yigithansari/ARGOS/images/hardware/phase-00/19-07-2026-power_module_back.jpeg

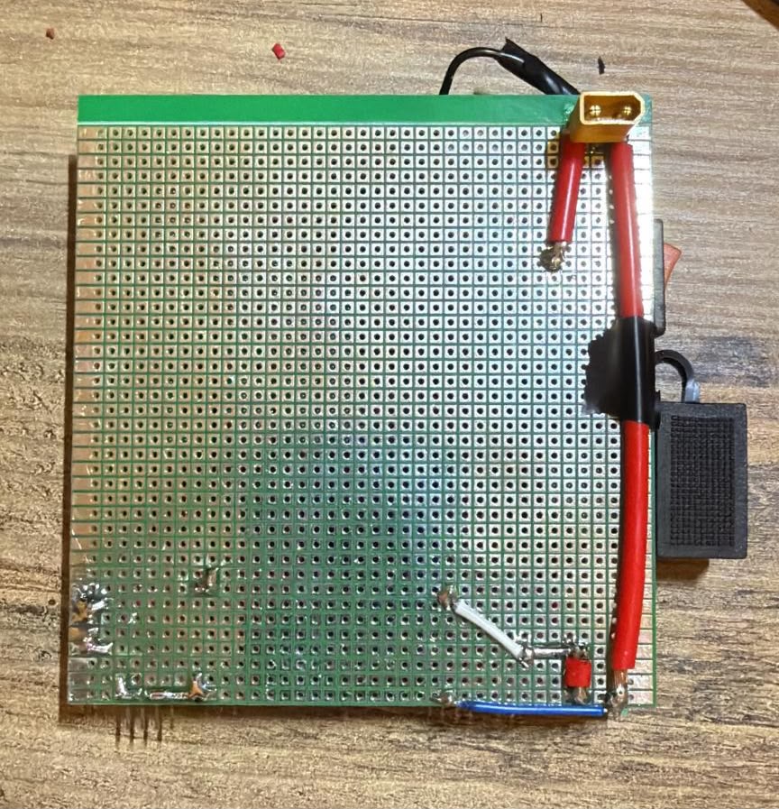
images/hardware/phase-00/19-07-2026-power_module_back.jpeg
