yigithansari/ARGOS/README.md

# ARGOS

## Autonomous Robotic Guard & Observation System

A long-term autonomous robotics platform developed to master embedded systems, robotics, autonomous navigation and system engineering.

## Current Status

**Phase 00 is certified, Phase 01 - Mobile Platform is complete, and Phase 02 - Motion Control is active.**

The Phase 00 bench platform passed its final integrated system test on 2026-09-29. It includes Power Module V1, STM32 firmware, independent bidirectional motor control, encoder telemetry, MPU6050 and dual VL53L0X sensing, USB/UART communication, an ESP32-C3 wireless bridge, an SSD1306 OLED status display, and a Python control panel. The archived [system-test report](tests/phase-00/2026-09-29-system-test-report.txt) records the certification evidence.

The first mobile platform is assembled. Chassis V1 and Wheel V5 manufacturing files are archived under [`hardware/mechanical/`](hardware/mechanical/), and current photographs are stored under [`images/hardware/phase-01/`](images/hardware/phase-01/). The robot can move and stop safely under computer control through a Windows hotspot and the ESP32-C3 bridge.

Phase 02 currently focuses on per-wheel feed-forward plus PI speed control. Wheel geometry, encoder scaling, and low-band PWM/RPM characterization are complete. Single raised-wheel forward runs at 25, 35, and 45 RPM met the initial mean tracking target; repeated runs, reverse operation, disconnect-stop latency, and floor tuning remain open. Battery charge level is not currently measured or displayed.

## Overview

ARGOS is a long-term engineering project focused on designing and developing a modular autonomous indoor security robot.

Unlike hobby robots, ARGOS is not intended to be a simple proof-of-concept or an Arduino-based demonstration platform. It is being developed using a professional product development methodology where every subsystem is validated before custom hardware is designed.

The project combines embedded systems, electronics, robotics, software engineering and autonomous decision-making into a single evolving platform.

The ultimate objective is to create a reliable robotic system while documenting every engineering decision throughout the development process.

## Why ARGOS?

The primary goal of ARGOS is education through engineering.

Instead of building isolated projects, ARGOS acts as a continuously evolving robotics platform where every new subsystem extends the capabilities of the previous generation.

By the end of the project, ARGOS will demonstrate practical experience in:

- Embedded Systems
- STM32 Development
- PCB Design
- Motor Control
- Robotics
- Sensor Fusion
- Autonomous Navigation
- Battery Management
- Communication Systems
- Software Architecture
- System Engineering
- Product Development

## Project Philosophy

ARGOS follows one fundamental engineering principle:

> Validate first. Design later.

Every subsystem is first implemented using development boards and modular hardware.

Only after validating the electrical, mechanical and software architecture will dedicated PCBs be designed.

This approach minimizes redesign effort while closely following industrial product development workflows.

## Long-Term Vision

The final version of ARGOS is planned to become a fully autonomous indoor security robot capable of:

- Autonomous indoor navigation
- Patrol missions
- Obstacle avoidance
- Environment perception
- Remote mission execution
- Wireless telemetry
- Home server integration
- Automatic charging (future)
- Camera-based monitoring (future)
- Event logging
- Future self-balancing platform

## System Architecture

                   Home Server
             (MQTT - Dashboard - Logs)
                         |
                   Wi-Fi (Future)
                         |
                Raspberry Pi / SBC
                         |
                    UART / SPI
                         |
                STM32 Main Controller
                         |
        +----------------+----------------+
        |                |                |
   Motor Control    Sensor System    Power System
        |                |                |
  Encoder Motors     IMU - ToF      Battery - BMS

## Development Roadmap

### Phase 00 - Bench Validation

**Status:** Complete - Certified 2026-09-29.

The objective of this phase is validating all core hardware modules independently.

Topics:

- STM32 development environment
- PWM generation
- Encoder reading
- Motor driver evaluation
- Serial debugging

### Phase 01 - Mobile Platform

Build the first functional mobile robot.

**Status:** Complete - assembled mobile platform and safe basic motion.

Main goals:

- Differential drive
- Encoder feedback
- PID speed control
- Reliable movement

### Phase 02 - Motion Control

Develop repeatable closed-loop wheel-speed and differential-drive control.

**Status:** Active - PI tuning.

Topics:

- Independent wheel-speed PI control
- Straight-line repeatability
- Wheel odometry
- Distance and angle commands

### Phase 03 - Localization and Basic Autonomy

Introduce autonomous behavior.

Features:

- Obstacle avoidance
- Basic navigation
- Safety state machine

### Phase 04 - Custom Electronics

Replace development boards with custom-designed hardware.

Goals:

- STM32 custom PCB
- Motor driver PCB
- Power distribution
- Professional wiring architecture

### Phase 05 - Home Server Integration

Enable wireless communication.

Features:

- MQTT
- Telemetry
- Dashboard
- Remote mission commands

### Phase 06 - Security Robot

Transform ARGOS into an autonomous indoor security platform.

Possible capabilities:

- Patrol mode
- Monitoring
- Event detection
- Logging
- Camera integration

### Phase 07 - Next Generation Platform

Potential future upgrades:

- Self-balancing platform
- Improved perception
- Advanced autonomy
- Additional robotic modules

## Technologies

### Embedded

- STM32F446RE
- STM32 HAL
- Embedded C

### Electronics

- Altium Designer
- PCB Design
- Power Electronics

### Robotics

- Differential Drive
- PID Control
- Odometry
- Sensor Fusion

### Software

- Python
- Git
- GitHub

### Future Technologies

- Raspberry Pi
- MQTT
- Docker
- Home Assistant
- Proxmox
- OpenCV

## Repository Structure

- `docs/` - Project vision, requirements, architecture, and implementation documentation.
- `phases/` - Authoritative phase register and detailed active/completed phase records.
- `hardware/` - Mechanical and future electronic design files, including Chassis V1.
- `firmware/` - STM32 and ESP32-C3 firmware projects.
- `software/` - Python control, telemetry, and validation tools.
- `tests/` - Certification evidence, validation reports, and future phase test records.
- `journal/` - Chronological engineering decisions and milestone records.
- `images/` - Diagrams and phase-specific hardware/software evidence.
- `resources/`, `tools/`, `videos/`, `archive/` - Supporting project material.

See the [`phases/` register](phases/README.md) for the current engineering state.

## Documentation

Every engineering decision will be documented.

The repository will include:

- Project Architecture
- Hardware Architecture
- Software Architecture
- Mechanical Design
- Test Reports
- Development Logs
- Lessons Learned
- Bill of Materials (BOM)
- Design Reviews

## Engineering Principles

ARGOS is developed according to the following principles:

- Modularity
- Reliability
- Maintainability
- Scalability
- Documentation First
- Incremental Development
- Version Control
- Engineering Validation Before Hardware Design

## License

This repository is currently intended for educational and portfolio purposes.
