yigithansari/ARGOS/phases/README.md

# ARGOS Development Phases

This directory is the authoritative phase register for ARGOS.

## Current Phase

**Phase 02 - Motion Control is active.** The mobile platform is assembled and safe basic motion is available. Current work is independent wheel-speed PI tuning and repeatability validation.

## Phase Register

| Phase | Name | Status | Primary Record |
| --- | --- | --- | --- |
| Phase 00 | Bench Validation | Complete - Certified 2026-09-29 | [`phase-00-bench-validation.md`](phase-00-bench-validation.md) |
| Phase 01 | Mobile Platform | Complete - 2026-10-31 | [`phase-01-mobile-platform.md`](phase-01-mobile-platform.md) |
| Phase 02 | Motion Control | Active - PI tuning | [`phase-02-motion-control.md`](phase-02-motion-control.md) |
| Phase 03 | Localization and Basic Autonomy | Planned | To be created when Phase 02 exit criteria are met. |
| Phase 04 | Custom Electronics | Planned | To be created when platform requirements stabilize. |
| Phase 05 | Home Server Integration | Planned | Future phase. |
| Phase 06 | Security Robot | Planned | Future phase. |
| Phase 07 | Next Generation Platform | Concept | Long-term expansion. |

## Phase Rules

- Each active phase has one detailed phase document.
- Completed phases retain their evidence, limitations, and exit decision.
- Work carried forward is tracked in the active phase without reopening a certified phase.
- New phase documents are created only when the project formally enters that phase.
