yigithansari/ARGOS/images/hardware/phase-01/README.md

# Phase 01 Mobile Platform Photos

This directory contains the first assembled ARGOS mobile-platform photographs.

## Files

- `2026-10-31_ARGOS_Mobile_Platform_Top_View.jpeg` - Top view of the completed chassis, electronics, power module, motor drivers, sensors, and wiring.
- `2026-10-31_ARGOS_Mobile_Platform_Three_Quarter_View.jpeg` - Three-quarter view showing the assembled chassis and wheel installation.

These photographs document the Phase 01 mobile-platform integration baseline before Phase 02 PI tuning and odometry work.
