yigithansari/ARGOS/images/software/phase-00/README.md

# Phase 00 Software Evidence

This directory contains screenshots of the ARGOS control and telemetry interface used during final Phase 00 bench validation.

## Files

- `2026-09-29_ARGOS_Control_Panel_Overview.png` - Full control-panel overview with active Wi-Fi and STM32 connection.
- `2026-09-29_ARGOS_Control_Panel_Telemetry.png` - IMU, ToF, and serial telemetry view during integrated operation.

The machine-generated validation record is stored at `tests/phase-00/2026-09-29-system-test-report.txt`.
