yigithansari/ARGOS/tests/reports/2026-09-17_Phase00_Exit_Report.md

# Phase 00 Exit Report

**Project:** ARGOS - Autonomous Robotic Guard & Observation System
**Phase:** Phase 00 - Bench Validation
**Report Date:** 2026-09-17
**Decision:** Phase 00 Complete - Approved to Proceed to Phase 01
**Certification Date:** 2026-09-29
**Certification Status:** Passed

## 1. Purpose

This report records the formal completion of ARGOS Phase 00. The phase established and validated the electrical, embedded-software, sensing, motor-control, communication, and operator-interface foundation required for the first mobile platform.

Phase completion does not imply that every subsystem has reached final product maturity. It confirms that the bench platform is sufficiently understood, functional, documented, and controlled to begin Phase 01 integration.

## 2. Exit Summary

Phase 00 exit is approved.

The STM32 development workflow, power distribution, motor-driver operation, encoder acquisition, IMU, dual ToF sensing, USB/UART control, ESP32-C3 wireless bridge, OLED status display, and Python control panel have been brought up on the bench.

The remaining calibration and instrumentation-dependent measurements are documented and accepted as carry-over work. None currently prevents controlled mechanical integration.

The exit decision was confirmed by the final integrated system test on 2026-09-29. The generated report records PASS results for UART, I2C discovery, IMU, both ToF sensors, motor safety, encoder response, and bidirectional motor ramps.

## 3. Validated Capabilities

| Area | Result | Evidence / Notes |
| --- | --- | --- |
| STM32 development environment | Passed | Build, upload, debug, and runtime workflow established for NUCLEO-F446RE. |
| Power Module V1 | Passed with open measurements | Electrical checks passed; approved for controlled bench use. Thermal and oscilloscope measurements remain open. |
| UART and USB control | Passed | Command reception and telemetry verified through the STM32 serial interface. |
| Python control panel | Passed | Manual drive controls, telemetry, connection handling, and test functions implemented. |
| PWM generation | Passed | Independent left and right motor commands are operational. |
| Motor-driver operation | Passed | Motor isolation, direction control, stopping, and ramp operation verified. |
| Encoder acquisition | Passed with calibration pending | Direction and count telemetry verified. CPR and gearbox ratio require calibration for accurate wheel RPM. |
| MPU6050 IMU | Passed | Communication and sensor telemetry verified. |
| Dual VL53L0X ToF sensors | Passed | Address assignment and distance telemetry verified for both sensors. |
| ESP32-C3 wireless bridge | Passed | Wi-Fi SoftAP and TCP-to-UART control path implemented with disconnect stop behavior. |
| SSD1306 OLED status display | Passed | STM32-driven local status display integrated. |
| Safety behavior | Passed | Startup stop state, command timeout, direction-change stop window, and emergency stop path implemented. |

## 3.1 Final Certification Evidence

- `tests/phase-00/2026-09-29-system-test-report.txt`
- `tests/phase-00/README.md`
- `images/software/phase-00/2026-09-29_ARGOS_Control_Panel_Overview.png`
- `images/software/phase-00/2026-09-29_ARGOS_Control_Panel_Telemetry.png`
- `images/hardware/phase-00/ARGOS_Phase00_Bench_Platform_Top_View.jpg`

## 4. Phase Deliverables

- Reusable Power Module V1 bench supply and distribution assembly
- STM32CubeIDE firmware project for NUCLEO-F446RE
- Motor, encoder, IMU, ToF, UART, safety, and OLED firmware functions
- ESP32-C3 Wi-Fi-to-UART bridge firmware
- Python desktop control panel
- System diagrams, implementation notes, journal entries, and validation reports
- Recorded pin mappings, command interface, and current hardware architecture

## 5. Accepted Carry-Over Items

The following work remains open and shall continue during early Phase 01 integration:

| Item | Current State | Phase 01 Action |
| --- | --- | --- |
| Low-PWM motor deadband | Motors require a minimum command to overcome static friction, gearbox friction, and internal losses. | Measure each motor's startup threshold and implement minimum-command compensation or a controlled startup kick if required. |
| Encoder scale calibration | Counts and direction are available; physical conversion is not final. | Measure encoder CPR and gearbox ratio, then calibrate wheel RPM and odometry constants. |
| ToF distance calibration | Functional ranging is verified. | Compare readings against known distances and record correction or tolerance. |
| IMU angle validation | Sensor communication and telemetry are verified. | Validate roll and pitch against known reference angles. |
| Power-module thermal test | Not measured with dedicated thermal equipment. | Perform an extended loaded run and record component temperatures when suitable equipment is available. |
| Rail ripple and motor transient test | Not measured because an oscilloscope was unavailable. | Measure 5V ripple and 12V motor-start transients when an oscilloscope is available. |
| Battery level monitoring | Not implemented; charge level is not visible. | Add and validate a battery-voltage sensing circuit during Phase 01 before relying on software state-of-charge indication. |
| Firmware module split | Current platform behavior is concentrated in `argos_platform.c`. | Separate stable functions into dedicated modules as Phase 01 behavior settles. |

## 6. Known Limitations

- The current platform is a bench prototype and is not a final production electrical design.
- Accurate wheel RPM and odometry are not available until encoder scaling is calibrated.
- Very low PWM commands may not produce motion and shall not be treated as a guaranteed operating region.
- Power Module V1 is approved for controlled development use, not certified as a final power subsystem.
- Thermal and oscilloscope-based power-quality evidence is not yet available.

## 7. Exit Criteria Assessment

| Exit Criterion | Assessment |
| --- | --- |
| Development environment operational | Met |
| Power architecture usable for bench integration | Met with documented measurement carry-over |
| Motor control and safe stop behavior operational | Met |
| Encoder direction and counting available | Met; scale calibration carried forward |
| IMU and ToF interfaces operational | Met |
| Wired and wireless command paths operational | Met |
| Operator telemetry and local status available | Met |
| Known limitations documented | Met |
| Repository contains implementation and validation evidence | Met |

## 8. Engineering Decision

ARGOS Phase 00 - Bench Validation is complete as of 2026-09-17.

The platform is approved to proceed to **Phase 01 - Mobile Platform**, with the carry-over items in this report tracked during early mechanical and motion integration. Any wiring, load profile, motor, encoder, battery, or power-module change shall trigger targeted revalidation of the affected subsystem.
