yigithansari/ARGOS/docs/02_engineering_principles.md

# ARGOS Engineering Principles

**Document ID:** DOC-002
**Document Title:** Engineering Principles
**Version:** 1.0 (Draft)
**Status:** Active
**Project:** ARGOS – Autonomous Robotic Guard & Observation System

---

## 1. Purpose

This document defines the engineering principles that guide every design decision made throughout the ARGOS project.

Unlike technical requirements, engineering principles are not tied to a specific subsystem or development phase. Instead, they establish the philosophy behind the project and provide a consistent framework for evaluating future decisions.

Whenever multiple technical solutions are possible, these principles should be used to determine the most appropriate engineering choice.

---

## 2. Why Engineering Principles?

Large engineering projects often fail not because of poor implementation, but because decisions become inconsistent over time.

As the ARGOS platform evolves, dozens of hardware, software and mechanical decisions will be made.

This document exists to ensure those decisions remain consistent with the original vision of the project.

Engineering principles reduce unnecessary redesign, simplify future maintenance and improve long-term system reliability.

---

## 3. Core Engineering Principles

### EP-001 — Validate Before Designing

Prototype first.

Custom hardware later.

Every subsystem shall first be validated using development boards or modular hardware before designing dedicated PCBs.

No custom PCB should be designed based solely on theoretical assumptions.

---

### EP-002 — Reliability Before Features

A reliable robot with fewer features is always preferred over a feature-rich robot that behaves unpredictably.

New capabilities must never reduce system stability.

---

### EP-003 — Safety Before Performance

System safety shall always have higher priority than speed, autonomy or additional functionality.

The robot shall always be capable of entering a safe state when unexpected conditions occur.

---

### EP-004 — Incremental Development

ARGOS shall evolve through small measurable milestones.

Every completed phase must leave the robot in a fully functional state before additional complexity is introduced.

Large architectural redesigns should be avoided whenever possible.

---

### EP-005 — Modular Design

Every subsystem should be designed as independently as practical.

Examples include:

- Motor control
- Power distribution
- Sensor interfaces
- Communication
- Navigation
- Diagnostics

Subsystems should communicate through clearly defined interfaces.

---

### EP-006 — Documentation First

Every important engineering decision shall be documented.

Documentation should explain:

- Why the decision was made.
- Which alternatives were considered.
- What trade-offs were accepted.

Future engineers should be able to understand the reasoning behind every major design choice.

---

### EP-007 — Testability

Every subsystem shall be testable independently.

Testing should not require the complete robot whenever possible.

Individual hardware modules should support standalone validation.

---

### EP-008 — Simplicity

Whenever two solutions provide similar performance, the simpler solution should be selected.

Complexity should only be introduced when it provides measurable engineering value.

---

### EP-009 — Scalability

Every subsystem should allow future expansion without requiring complete redesign.

The first generation should not limit future generations.

---

### EP-010 — Maintainability

Hardware shall be easy to assemble, disassemble and repair.

Firmware shall remain modular, readable and reusable.

Future maintenance should always be considered during design.

---

### EP-011 — Reusability

Subsystems developed for ARGOS should be reusable in future robotics or embedded projects whenever practical.

Knowledge gained from one subsystem should benefit future developments.

---

### EP-012 — Measurable Engineering

Engineering decisions should be supported by measurable data whenever possible.

Examples include:

- Current consumption
- Motor speed
- Battery runtime
- Sensor accuracy
- Response time

Engineering assumptions should eventually be replaced by experimental measurements.

---

### EP-013 — Controlled Complexity

New technologies should be introduced only after mastering the previous level of complexity.

For example:

Motor control → Odometry → Sensor Fusion → Navigation → Wireless Communication → Autonomy

Skipping intermediate learning stages is discouraged.

---

### EP-014 — Long-Term Thinking

Every component selected for ARGOS should be evaluated not only for the current phase, but also for its usefulness in future generations.

Hardware should be chosen to minimize unnecessary replacement.

---

### EP-015 — Engineering Integrity

The purpose of ARGOS is education through engineering.

Features shall never be added merely because they appear impressive.

Every implemented feature should solve a real engineering problem or teach a valuable engineering concept.

---

## 4. Decision Process

Whenever a new subsystem is introduced, the following questions should be answered before implementation:

1. Does it support the project vision?
2. Which engineering problem does it solve?
3. Does it violate any engineering principle?
4. Can it be tested independently?
5. Is it compatible with future project phases?
6. Is there a simpler solution?

Only after answering these questions should implementation begin.

---

## 5. Revision Policy

Engineering principles should remain stable throughout the lifetime of the project.

Changes should only be introduced when a strong engineering justification exists.

Frequent modifications to this document are discouraged.

---

## 6. Final Statement

Engineering principles represent the foundation of ARGOS.

They define not only how the robot will be built, but how engineering decisions will be made throughout the project's lifetime.

A successful engineering project is not measured solely by its final functionality, but also by the quality and consistency of the decisions made during its development.

These principles exist to ensure that ARGOS remains a professional engineering platform rather than becoming an unstructured collection of features.
