yigithansari/ARGOS/hardware/mechanical/wheels/v5/ARGOS_Wheel_Laser_Cut_V5_Preview.png

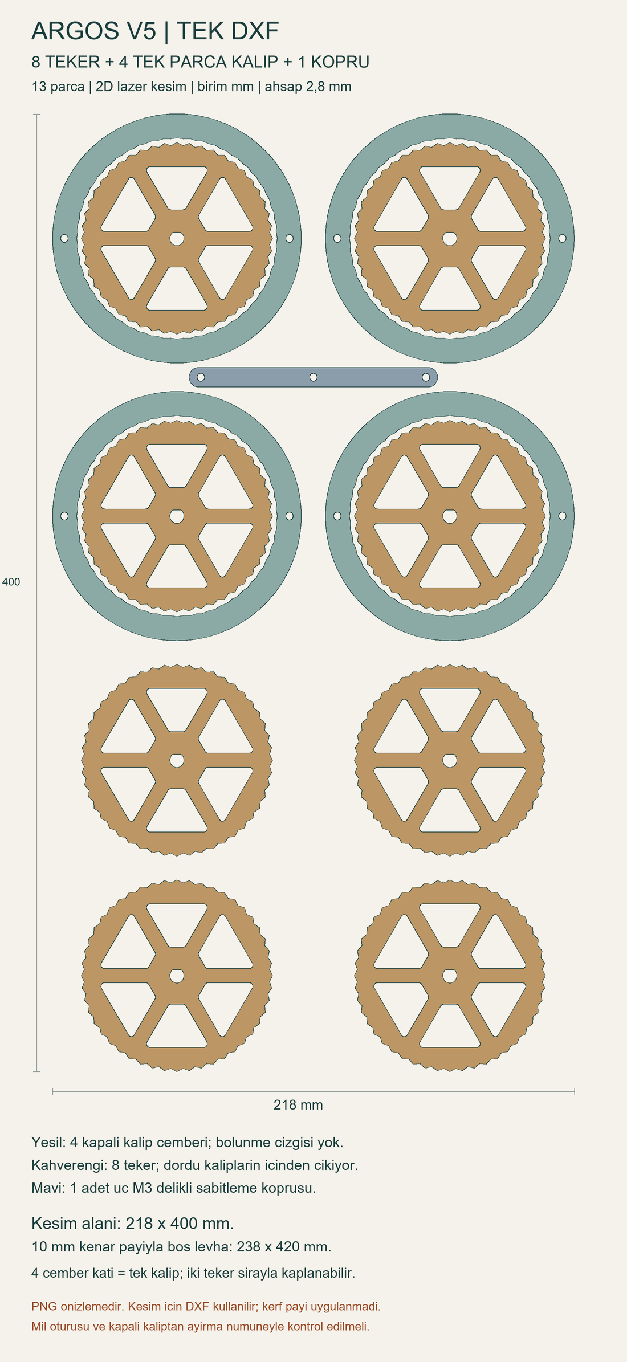
hardware/mechanical/wheels/v5/ARGOS_Wheel_Laser_Cut_V5_Preview.png
