yigithansari/ARGOS/images/diagrams/Phase00_Sysytem_Block_Diagram.png

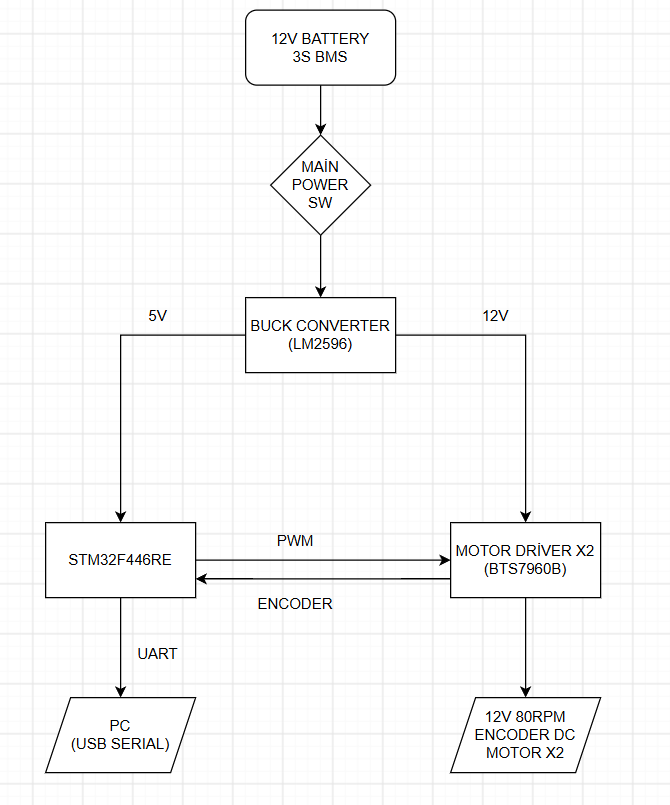
images/diagrams/Phase00_Sysytem_Block_Diagram.png
