yigithansari/ARGOS/images/hardware/19-07-2026-power_module_front.jpeg

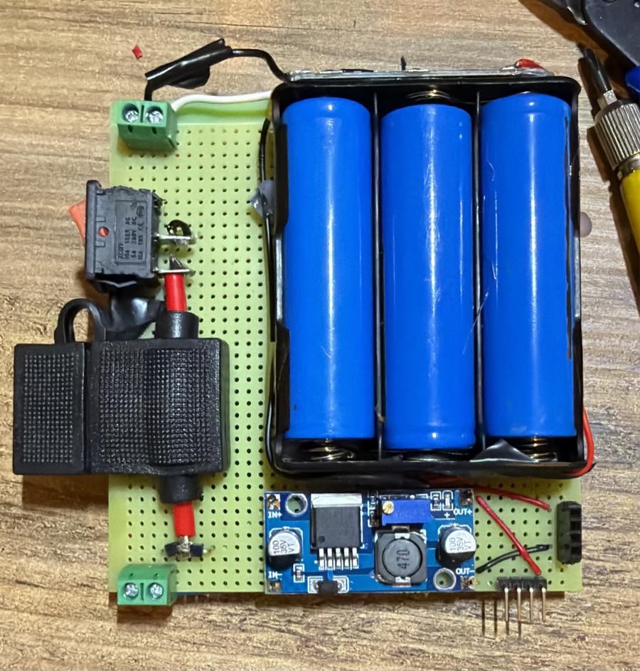
images/hardware/19-07-2026-power_module_front.jpeg
