yigithansari/ARGOS/images/hardware/phase-00/ARGOS_Phase00_Bench_Platform_Top_View.jpg

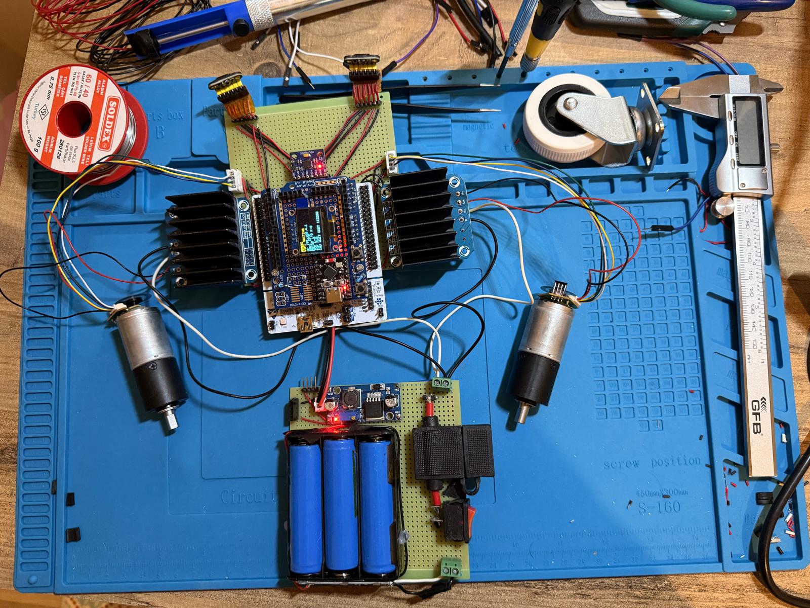
images/hardware/phase-00/ARGOS_Phase00_Bench_Platform_Top_View.jpg
