yigithansari/ARGOS/images/hardware/phase-01/2026-10-31_ARGOS_Mobile_Platform_Three_Quarter_View.jpeg

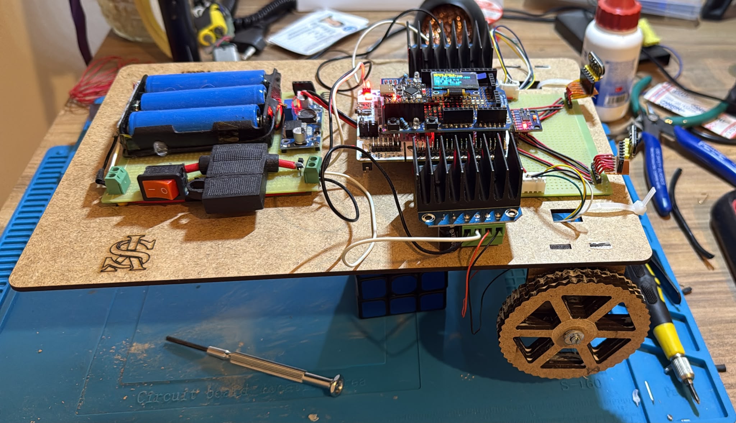
images/hardware/phase-01/2026-10-31_ARGOS_Mobile_Platform_Three_Quarter_View.jpeg
