yigithansari/ARGOS/images/software/phase-00/2026-09-29_ARGOS_Control_Panel_Telemetry.png

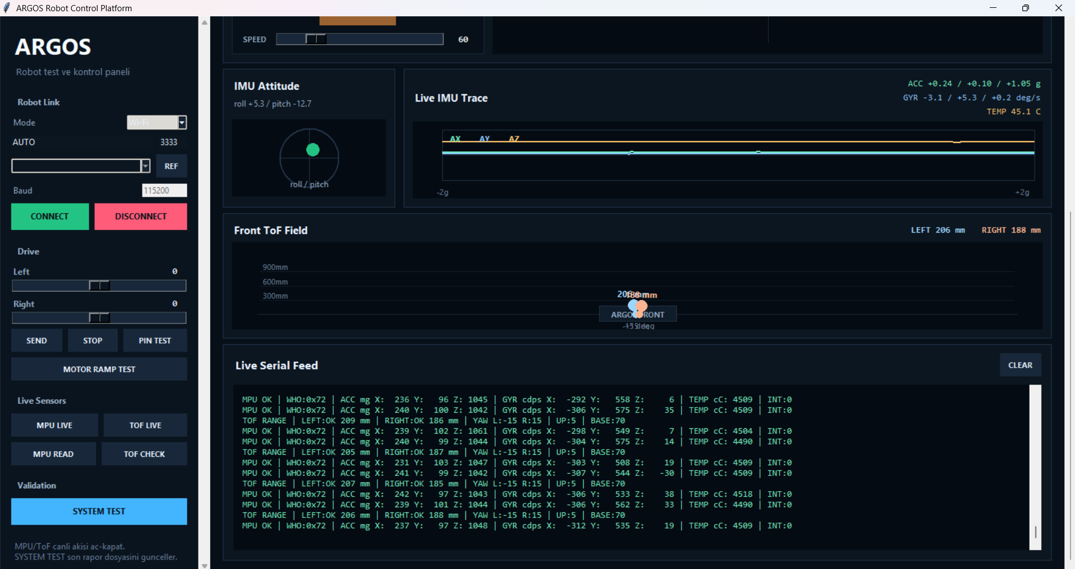
images/software/phase-00/2026-09-29_ARGOS_Control_Panel_Telemetry.png
