yigithansari/ARGOS/hardware/mechanical/wheels/v5/ARGOS_Wheel_Laser_Cut_V5.dxf

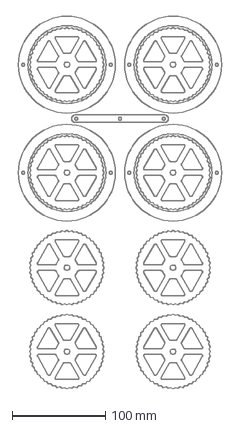
[picture p10: CAD file, 2026-10-31]
hardware/mechanical/wheels/v5/ARGOS_Wheel_Laser_Cut_V5.dxf
218.0 x 400.0 mm
