yigithansari/ARGOS/(list of files, cad)

Other CAD files:
hardware/mechanical/chassis/v1/ARGOS_Chassis_V1.dwg
hardware/mechanical/chassis/v1/ARGOS_Chassis_V1.f3d
