yigithansari/ARGOS/images/diagrams/Phase00_Wiring_Diagram.png

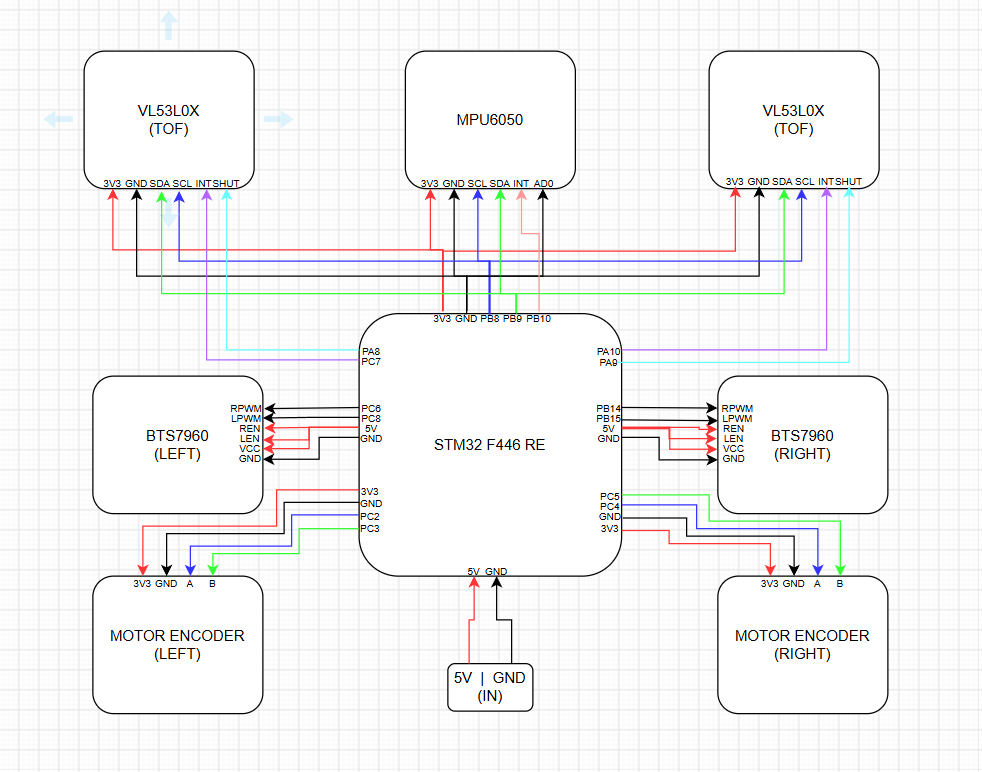
images/diagrams/Phase00_Wiring_Diagram.png
