yigithansari/ARGOS/tests/phase-00/README.md

# Phase 00 Certification Evidence

Status: COMPLETE

Certification date: 2026-09-29

The archived system-test report records the final integrated bench validation of the ARGOS Phase 00 platform.

## Result

- UART: PASS
- I2C: PASS, three devices found
- IMU: PASS
- Left ToF: PASS
- Right ToF: PASS
- Motor safety: PASS
- Encoders: PASS
- Bidirectional motor ramp: PASS

## Evidence

- `2026-09-29-system-test-report.txt`: immutable console report generated by the ARGOS control panel.

The test used the ESP32-C3 Wi-Fi bridge and completed the full STM32 sensor and motor sequence. Network-client/hotspot changes made after this certification require a transport regression run before publishing, while the certified hardware results remain valid.
