yigithansari/ARGOS/journal/31-10-2026_Phase01_Completion_Phase02_PI_Tuning.md

# Phase 01 Completion and Phase 02 PI Tuning

**Date:** 2026-10-31
**Previous Phase:** Phase 01 - Mobile Platform
**Current Phase:** Phase 02 - Motion Control

## Decision

Phase 01 is complete. Phase 02 is active and focused on per-wheel PI speed-control tuning.

## Phase 01 Result

- Chassis design, fabrication, and mechanical integration are complete.
- Power, STM32, ESP32-C3, OLED, motor drivers, encoders, IMU, and ToF sensors are installed.
- The mobile platform can move and stop safely under computer control through the hotspot connection.
- Command timeout and link-loss stop behavior remain active.

## Phase 02 Progress

- Wheel geometry and encoder scale calibration are complete.
- Direction-specific low-band PWM/RPM characterization is complete.
- Independent feed-forward plus PI wheel-speed loops are implemented.
- Single forward raised-wheel runs at 25, 35, and 45 RPM completed with acceptable mean tracking.

## Remaining

- Tune PI gains for repeatability and reduced low-speed variation.
- Validate reverse, turning, disconnect-stop latency, and floor behavior.
- Implement odometry and distance/angle commands.
- Add battery-voltage monitoring in a later Phase 02 revision.
