yigithansari/ARGOS/journal/17-09-2026_Phase00_Completion.md

# Phase 00 Completion

**Date:** 2026-09-17
**Phase:** Phase 00 - Bench Validation
**Topic:** Formal phase closure and transition to Phase 01

## Decision

Phase 00 is complete. ARGOS is approved to proceed to Phase 01 mobile-platform integration.

## Reason

The bench platform now provides working power distribution, STM32 control, motor drive, encoder feedback, IMU and dual-ToF telemetry, wired and wireless communication, local OLED status, and a Python operator interface. The remaining work consists of calibration, low-speed characterization, code modularization, and measurements that require thermal or oscilloscope equipment.

These open items are understood, documented, and do not prevent controlled mechanical integration.

## Result

- Power Module V1 is approved for controlled development use.
- Left and right motors can be controlled independently and safely.
- Encoder counts and direction are available; physical scaling remains to be calibrated.
- MPU6050 and both VL53L0X sensors are operational.
- USB/UART and ESP32-C3 Wi-Fi control paths are available.
- The SSD1306 OLED and Python control panel provide local and desktop status visibility.
- Phase 00 limitations and Phase 01 carry-over actions are recorded in the exit report.

## Next Actions

- Begin Phase 01 mechanical and mobile-platform integration.
- Characterize left and right motor deadband under the installed mechanical load.
- Calibrate encoder CPR, gearbox ratio, wheel RPM, and odometry constants.
- Validate ToF distance and IMU angle accuracy against known references.
- Add battery-voltage monitoring.
- Complete thermal and oscilloscope-based power checks when equipment is available.
- Split stable firmware functions into dedicated modules as integration progresses.

## Related Document

- `tests/reports/2026-09-17_Phase00_Exit_Report.md`
