yigithansari/ARGOS/journal/29-09-2026_Phase00_Certification.md

# Phase 00 Integrated Bench Certification

**Date:** 2026-09-29
**Phase:** Phase 00 - Bench Validation
**Topic:** Final integrated system test and certification

## Decision

Phase 00 is certified complete following a successful integrated system test of the ARGOS bench platform.

## Reason

The final automated sequence verified UART communication, all three I2C devices, MPU6050 telemetry, both VL53L0X sensors, motor safety state, encoder response, and independent bidirectional motor ramp operation through the ESP32-C3 Wi-Fi bridge.

## Result

- UART communication passed.
- Three I2C devices were detected.
- MPU6050 validation passed.
- Left and right VL53L0X validation passed.
- Motor safe-stop behavior passed.
- Left and right encoder response passed.
- Left and right forward/reverse ramp testing at 50, 60, 70, and 80 percent passed.
- Control-panel screenshots and the generated console report were archived as evidence.

## Phase 01 Carry-Over

- Battery level is not yet measured or displayed.
- Motor deadband and low-speed behavior require characterization under mechanical load.
- Encoder CPR and gearbox ratio require calibration for physical wheel speed and odometry.
- Precision ToF and IMU calibration remains open.
- Power-module thermal and oscilloscope measurements remain open until suitable equipment is available.

## Evidence

- `tests/phase-00/2026-09-29-system-test-report.txt`
- `images/software/phase-00/2026-09-29_ARGOS_Control_Panel_Overview.png`
- `images/software/phase-00/2026-09-29_ARGOS_Control_Panel_Telemetry.png`
- `tests/reports/2026-09-17_Phase00_Exit_Report.md`
