yigithansari/ARGOS/firmware/esp32_c3_argos_bridge/wifi_secrets.example.h

#pragma once

constexpr char ARGOS_WIFI_SSID[] = "YOUR_HOTSPOT_NAME";
constexpr char ARGOS_WIFI_PASSWORD[] = "YOUR_HOTSPOT_PASSWORD";
constexpr char ARGOS_FALLBACK_AP_PASSWORD[] = "CHOOSE_A_FALLBACK_AP_PASSWORD";
